StMarian/mouse-mover/hardware/mm-v1.kicad_pcb

## KiCad design hardware/mm-v1.kicad_pcb (2026-11-02)

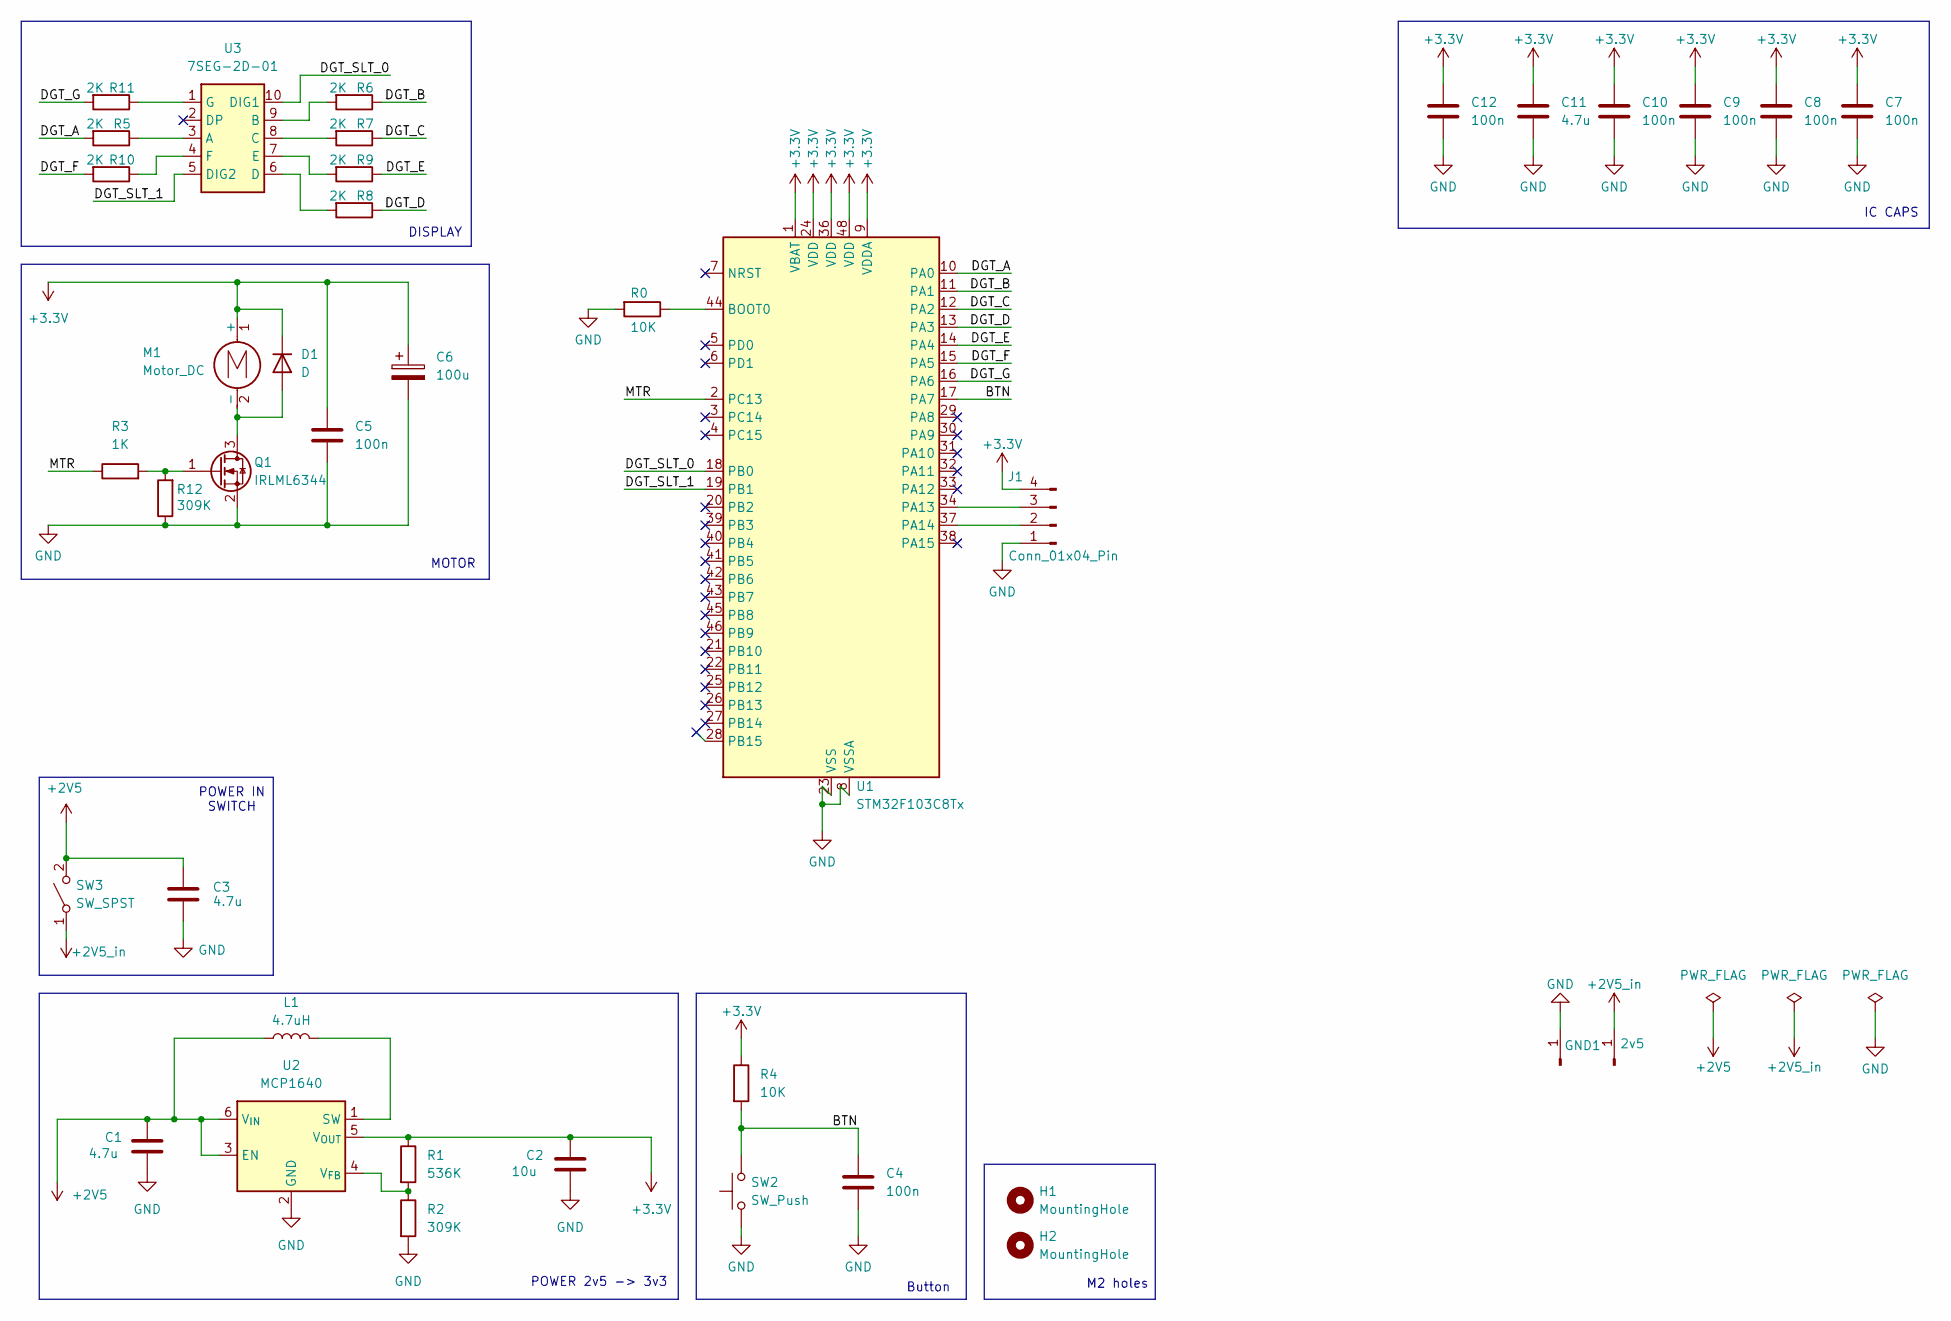
[picture p1: schematic mm-v1.kicad_sch]

Parts:
2v5: 2v5; SolderWirePad_1x01_SMD_2x4mm
C1, C3, C11: 4.7u; C_0805_2012Metric
C2: 10u; C_0805_2012Metric
C4, C5, C7, C8, C9, C10, C12: 100n; C_0805_2012Metric
C6: 100u; CP_Elec_6.3x5.7
D1: D; D_SOD-323
GND1: GND; SolderWirePad_1x01_SMD_2x4mm
H1, H2: MountingHole; MountingHole_2.2mm_M2
J1: Conn_01x04_Pin; PinHeader_1x04_P2.54mm_Vertical
L1: 4.7uH; L_Ferrocore_DLG-0504
M1: Motor_DC; JST_GH_BM02B-GHS-TBT_1x02-1MP_P1.25mm_Vertical
Q1: IRLML6344; SOT-23
R0, R4: 10K; R_0805_2012Metric
R1: 536K; R_0805_2012Metric
R2, R12: 309K; R_0805_2012Metric
R3: 1K; R_0805_2012Metric
R5, R6, R7, R8, R9, R10, R11: 2K; R_0805_2012Metric
SW2: SW_Push; JST_GH_BM02B-GHS-TBT_1x02-1MP_P1.25mm_Vertical
SW3: SW_SPST; JST_GH_BM02B-GHS-TBT_1x02-1MP_P1.25mm_Vertical
U1: STM32F103C8Tx; LQFP-48_7x7mm_P0.5mm
U2: MCP1640; SOT-23-6
U3: 7SEG-2D-01; PinHeader_2x05_P2.54mm_Vertical

Connections:
+2V5: C1.1, C3.1, L1.1, SW3.2 (B), U2.3 (EN), U2.6 (V_{IN})
+2V5_in: 2v5.1 (Pin_1_1), SW3.1 (A)
+3.3V: C2.1, C5.1, C6.1, C7.1, C8.1, C9.1, C10.1, C11.1, C12.1, D1.1 (K), J1.4, M1.1 (+), R1.1, R4.1, U1.1 (VBAT), U1.9 (VDDA), U1.24 (VDD), U1.36 (VDD), U1.48 (VDD), U2.5 (V_{OUT})
/BTN: C4.2, R4.2, SW2.2, U1.17 (PA7)
/DGT_A: R5.2, U1.10 (PA0)
/DGT_B: R6.1, U1.11 (PA1)
/DGT_C: R7.1, U1.12 (PA2)
/DGT_D: R8.1, U1.13 (PA3)
/DGT_E: R9.1, U1.14 (PA4)
/DGT_F: R10.2, U1.15 (PA5)
/DGT_G: R11.2, U1.16 (PA6)
/DGT_SLT_0: U1.18 (PB0), U3.10 (DIG1)
/DGT_SLT_1: U1.19 (PB1), U3.5 (DIG2)
/MTR: R3.1, U1.2 (PC13)
GND: C1.2, C2.2, C3.2, C4.1, C5.2, C6.2, C7.2, C8.2, C9.2, C10.2, C11.2, C12.2, GND1.1 (Pin_1_1), J1.1, Q1.2 (S), R0.2, R2.2, R12.1, SW2.1, U1.8 (VSSA), U1.23 (VSS), U1.35 (VSS), U1.47 (VSS), U2.2 (GND)
unnamed: D1.2 (A), M1.2 (-), Q1.3 (D)
unnamed: J1.2, U1.37 (PA14)
unnamed: J1.3, U1.34 (PA13)
unnamed: Q1.1 (G), R3.2, R12.2
unnamed: R0.1, U1.44 (BOOT0)
unnamed: L1.2, U2.1 (SW)
unnamed: R1.2, R2.1, U2.4 (V_{FB})
unnamed: R5.1, U3.3 (A)
unnamed: R6.2, U3.9 (B)
unnamed: R7.2, U3.8 (C)
unnamed: R8.2, U3.6 (D)
unnamed: R9.2, U3.7 (E)
unnamed: R10.1, U3.4 (F)
unnamed: R11.1, U3.1 (G)

Notes on the sheet:
Button
POWER 2v5 -> 3v3
M2 holes
MOTOR
POWER IN SWITCH
DISPLAY
IC CAPS

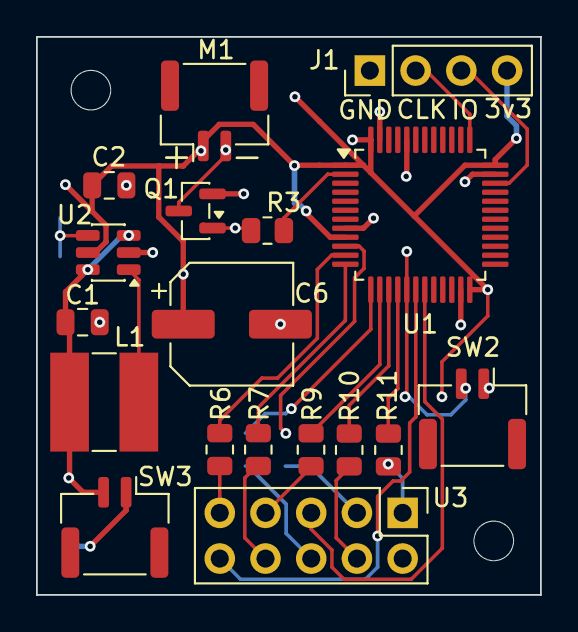
[picture p2: board mm-v1.kicad_pcb from above]

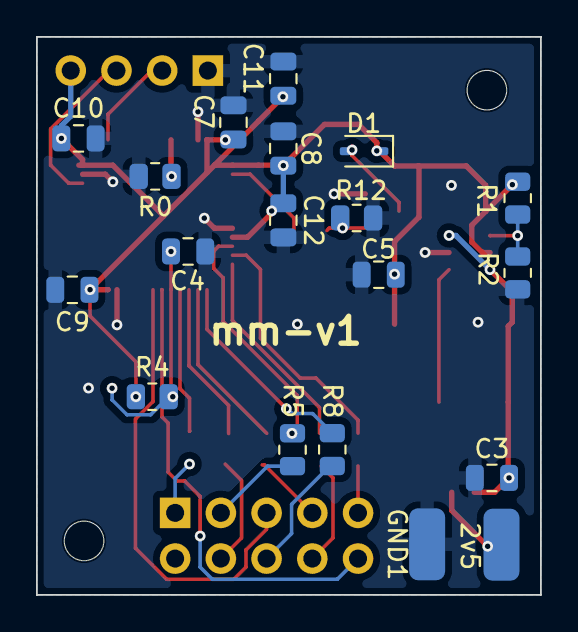
[picture p3: board mm-v1.kicad_pcb from below]

Board: 2 copper layers, 28.0 x 31.0 mm, 39 parts (19 on the bottom side), 29 nets.
