StMarian/mouse-mover/firmware/Core/Inc/main.h

#define LED_Pin GPIO_PIN_13
#define LED_GPIO_Port GPIOC
#define DGT_A_Pin GPIO_PIN_0
#define DGT_A_GPIO_Port GPIOA
#define DGT_B_Pin GPIO_PIN_1
#define DGT_B_GPIO_Port GPIOA
#define DGT_C_Pin GPIO_PIN_2
#define DGT_C_GPIO_Port GPIOA
#define DGT_D_Pin GPIO_PIN_3
#define DGT_D_GPIO_Port GPIOA
#define DGT_E_Pin GPIO_PIN_4
#define DGT_E_GPIO_Port GPIOA
#define DGT_F_Pin GPIO_PIN_5
#define DGT_F_GPIO_Port GPIOA
#define DGT_G_Pin GPIO_PIN_6
#define DGT_G_GPIO_Port GPIOA
#define BTN_Pin GPIO_PIN_7
#define BTN_GPIO_Port GPIOA
#define DGT_SLT_0_Pin GPIO_PIN_0
#define DGT_SLT_0_GPIO_Port GPIOB
#define DGT_SLT_1_Pin GPIO_PIN_1
#define DGT_SLT_1_GPIO_Port GPIOB
